nguyenductao1602-cmd/MULTI-GAS-IOT-MONITORING-SYSTEM/(commit log)

2026-10-17 VER1.0
    VER1.0
    [partitions.csv]
2026-10-17 Check/test V1
    Build for checking/testing sensor V1
    [partitions.csv]
2026-10-19 Ver2.0
    Update
    Ver2.0
    [partitions.csv]
